arshacker/MICROMOUSE--THE-GREAT-CHEESE-HUNT/TECH BULLETIN #6 CHEESE HUNT.docx

THE GREAT CHEESE HUNT

A NEW MICROMOUSE EVENT

TECHNICAL BULLETIN #6

PUBLICATION RIGHTS RESERVED

ADDRESS QUESTIONS TO:

DR. ANDREW R. SASS

IEEE, L.I. SECTION

arshacker@aol.com

IT IS ASSUMED THAT THE READER IS FAMILIAR WITH MICROMOUSE: THE GREAT CHEESE HUNT - TECH BULLETIN #1, #2, #3, #4,#5.

The Author is grateful to Sean Watts, coach of the Stevens Institute of Technology Micromouse Team, for the experimental observation that led to the work described in this section of the Bulletin.

As described in Tech Bulletin #1-#5, the IR Sensor, TL 1838, used by the Mouse and the Beacon (for Option 1) contains a 38 kHz bandpass filter to block stray ambient IR frequencies. The IR Sensor on the Mouse passes the 38 kHz modulated pulse generated by the Beacon. Similarly, in Option 2 the IR Sensor on the Beacon passes the 38 kHz signal generated by the Mouse.

While a bandpass filter blocks steady-state frequencies outside the bandpass, it does not block a step-function signal. This is true for any bandpass filter.

As a result, such signals, in this case usually due to IR Signals from a Mouse navigation system, can interfere with the operation of the Mouse-Beacon IR Sensing System. Obviously Mouse navigation using Ultrasonics or other technologies will not have this problem. However, the majority of Micromouse entrants use IR for navigation, hence the need for a solution to this problem.

The solution proposed here is a unique use of a pulse duration timer coupled with a double interrupt routine. The code for this solution is referenced below!!

The first interrupt is generated by the Falling Edge of the TL 1838 bandpass filter upon receiving any fast fall time IR signal. The second interrupt is generated by the Rising Edge of that IR Signal.

During the first interrupt, a millisecond clock is started and during the second interrupt the clock_time is measured. True Beacon and Mouse(option 1) signals are precisely 25 ms duration. The second interrupt interprets pulses of this duration as valid signals and rejects all others

Experiments done by S. Watts and the Author, independently, have verified the validity of this approach which I refer to as Pulse Width Filtering (PWF). The Author tested TDF using a VL53L0X Time-Of-Flight system running in Continuous Mode, 50 ms period. A diagram of the test and pulses received by the TL 1838 are shown in Fig. 1 and Fig. 2 below. Close up examination of those pulses and interrupts they cause do not meet the 25 ms required pulse width and are rejected by the PWF.

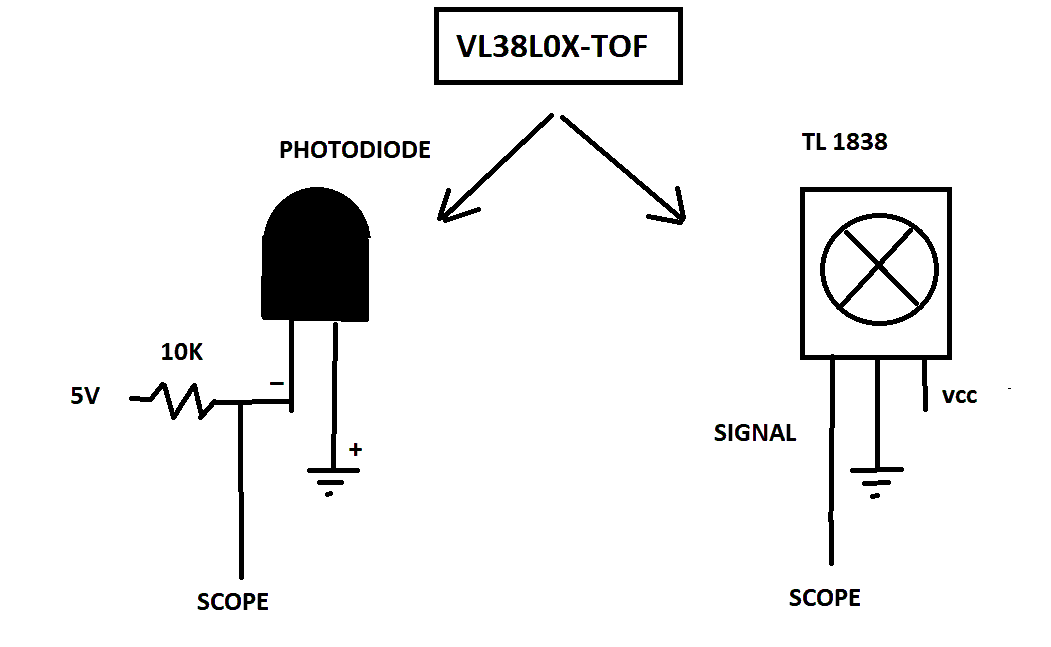
[picture p27: figure]

Fig. 1

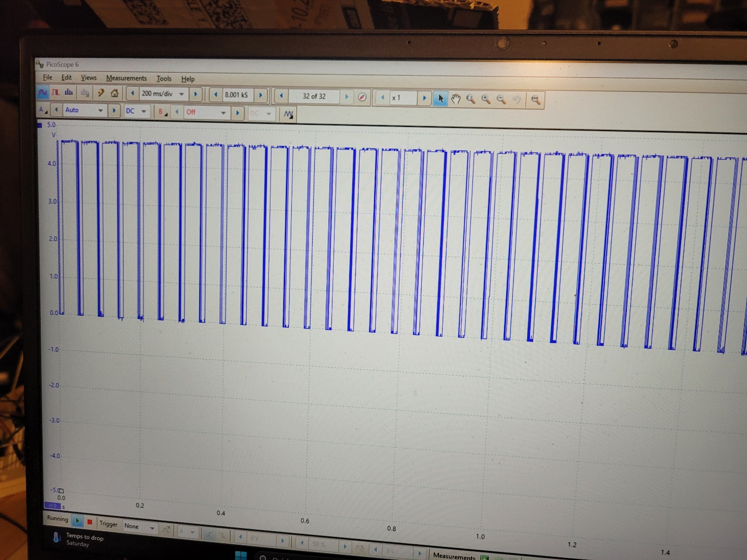
[picture p28: figure]

Fig. 2

The question that remains is what happens when a VL53L0X signal hits the TL 1838 at the same “time” as the Beacon signal. Analysis and experiments show that due to timing of each of those signals is different so that there will be instants where only one of those two signals will be active; PWF rejects the one which is not 25ms.

A similar PWF has been added to the Beacon proximity sensor for Option 2. In this case, if the proximity sensor is blocked for 1 sec or longer, the PWF passes the block as valid.

The latest code incorporating the above for the Beacon and Mouse can be found in this Github account: Beacon_GH_1 and

Mouse_SiM _GH_1.

IN USING THESE TWO CODES, THE USER SHOULD VERIFY, USING A SCOPE, THAT THE IR LED SIGNAL EMITTED AND RECEIVED BY THE SENSOR IN THEIR SETUP IS 25 ms PULSE WIDTH.

The Mouse code also cleans up the RED/GREEN LED action on the Mouse for Option 1, so that Mouse’s RED is ON when the Beacon is ON and Mouse’s GREEN is ON when the Beacon is OFF. (Beacon’s RED is ON when Beacon is ON and Beacon’s GREEN is ON when Beacon is OFF).
