arshacker/MICROMOUSE--THE-GREAT-CHEESE-HUNT/(commit log)

2025-06-17 MICROMOUSE: THE GREAT CHEESE HUNT
    A mouse (robot) autonomously searches a maze to find a 940nm IR Beacon, extinguish it, and return to Start. Beacon Code and Mouse Code for IR detection is given. Search code is user responsibility..
2025-12-06 MOUSE_SIM_GH_3
    Mouse code using PCINT for IR sensor. Incorporate Pulse Width Filtering into interrupt to eliminate IR noise spikes. Streamline Option 2 LED code.
    [MOUSE_SIM_GH_3.ino]
